ByronAP/ExciterDriver/hardware/BOM_Board_1_Schematic_1.xlsx

No. | Quantity | Comment | Designator | Footprint | Value | Manufacturer Part | Manufacturer | Supplier Part | Supplier
1 | 2 | 100uF | C1,C2 | C1206 | 100uF | CL31A107MQHNNNE | SAMSUNG(三星) | C15008 | LCSC
2 | 2 | 100nF | C3,C4 | C1206 | 100nF | CL31B104KBCNNNC | SAMSUNG(三星) | C24497 | LCSC
3 | 1 | 680uF | C5 | CAP-TH_BD10.0-P5.00-D1.0-FD | 680uF | ERF1EM681G16OT | AISHI(艾华集团) | C106522 | LCSC
4 | 1 | SS34 | D1 | SMA_L4.3-W2.6-LS5.2-RD |  | SS34 | MDD(辰达半导体) | C8678 | LCSC
5 | 1 | PSM712-LF-T7 | D2 | SOT-23-3_L3.0-W1.7-P0.95-LS2.9-BR |  | PSM712-LF-T7 | PROTEK | C32677 | LCSC
6 | 5 | BZT52B5V1 | D3,D4,D5,D6,D7 | SOD-123_L2.7-W1.6-LS3.7-RD |  | BZT52B5V1 | 宏嘉诚 | C19077393 | LCSC
7 | 1 | XF-508P-B-B | F1 | FUSE-TH_4P-L16.0-W6.7 |  | XF-508P-B-B | XFCN(兴飞) | C19727305 | LCSC
8 | 1 | PZ254V-11-02P | H2 | HDR-TH_2P-P2.54-V-M |  | PZ254V-11-02P | XFCN(兴飞) | C492401 | LCSC
9 | 1 | 33uH | L1 | IND-SMD_L10.8-W10.0_SLO1040H | 33uH | SLO1040H330MTT | Sunltech(韩国顺磁) | C182163 | LCSC
10 | 2 | KT-0603R | LED1,LED2 | LED0603-RD |  | KT-0603R | KENTO | C2286 | LCSC
11 | 1 | KT-0805G | LED3 | LED0805-R-RD |  | KT-0805G | KENTO | C2297 | LCSC
12 | 1 | IRLR3110ZTRPBF | Q1 | TO-252-3_L6.5-W5.8-P4.58-BL |  | IRLR3110ZTRPBF | Infineon(英飞凌) | C67277 | LCSC
13 | 1 | 0Ω | R1 | R0805 | 0Ω | 0805W8F0000T5E | UNI-ROYAL(厚声) | C17477 | LCSC
14 | 1 | 22kΩ | R2 | R0805 | 22kΩ | 0805W8F2202T5E | UNI-ROYAL(厚声) | C17560 | LCSC
15 | 2 | 100Ω | R3,R5 | R0805 | 100Ω | 0805W8F1000T5E | UNI-ROYAL(厚声) | C17408 | LCSC
16 | 2 | 10kΩ | R4,R11 | R0805 | 10kΩ | 0805W8F1002T5E | UNI-ROYAL(厚声) | C17414 | LCSC
17 | 3 | 150Ω | R6,R7,R8 | R0805 | 150Ω | 0805W8F1500T5E | UNI-ROYAL(厚声) | C17471 | LCSC
18 | 1 | 15kΩ | R9 | R0805 | 15kΩ | 0805W8F1502T5E | UNI-ROYAL(厚声) | C17475 | LCSC
19 | 1 | 1kΩ | R10 | R0805 | 1kΩ | 0805W8F1001T5E | UNI-ROYAL(厚声) | C17513 | LCSC
20 | 1 | LM2596SX-5.0/NOPB | U1 | TO-263-5_L10.2-W8.9-P1.70-TL |  | LM2596SX-5.0/NOPB | TI(德州仪器) | C10002 | LCSC
21 | 1 | NANO | U2 | NANO
22 | 3 | DB126V-5.0-2P-GN-P | U4,U5,U6 | CONN-TH_2P-P5.00_L7.8-W10.0 |  | DB126V-5.0-2P-GN-P | DORABO(地博电气) | C395849 | LCSC
