ByronAP/ExciterDriver/hardware/SCH_Schematic_1.pdf

# Power Supply

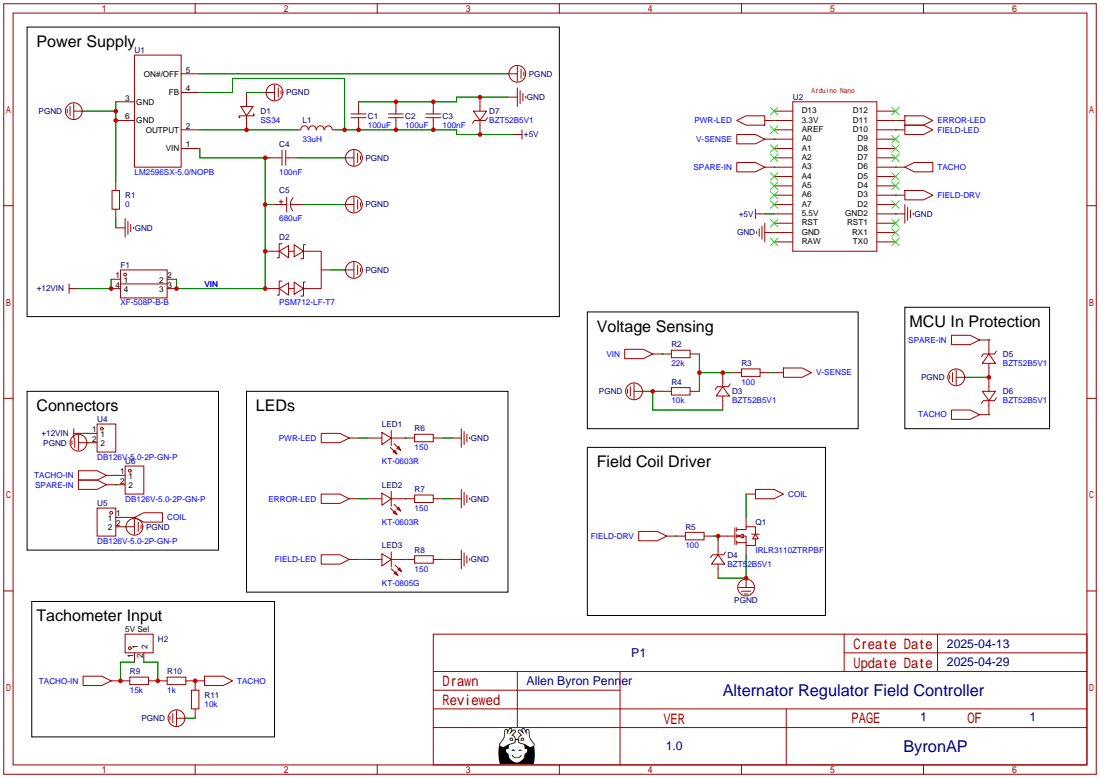
[picture p1: page 1]

Alternator Regulator Field Controller
