ByronAP/ExciterDriver/(commit log)

2025-06-10 feat: Initial project structure and source code for v2.9.0
    [BOM_Board_1_Schematic_1.xlsx]
2025-06-10 feat: Add CalibrationHelper to release artifacts
